xu5901/car_template/3-参考资料/编码器参数.jpg

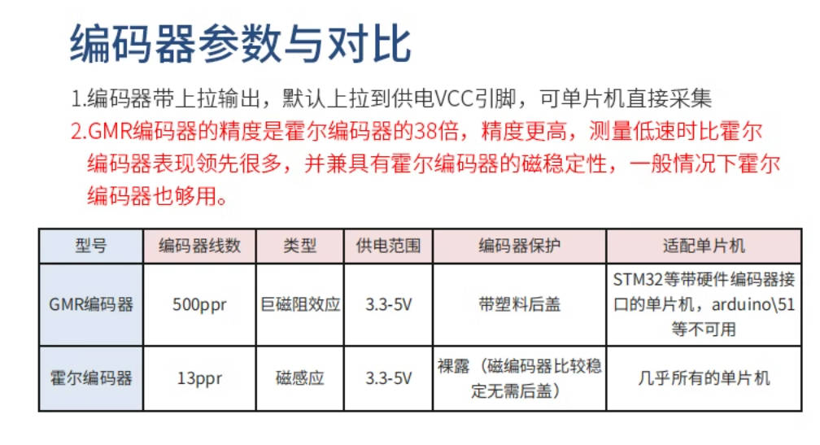
3-参考资料/编码器参数.jpg
