xu5901/car_template/4-小车PCB/小车基本板/3.说明文档/小车基本板A4950_PCB_3D预览.jpg

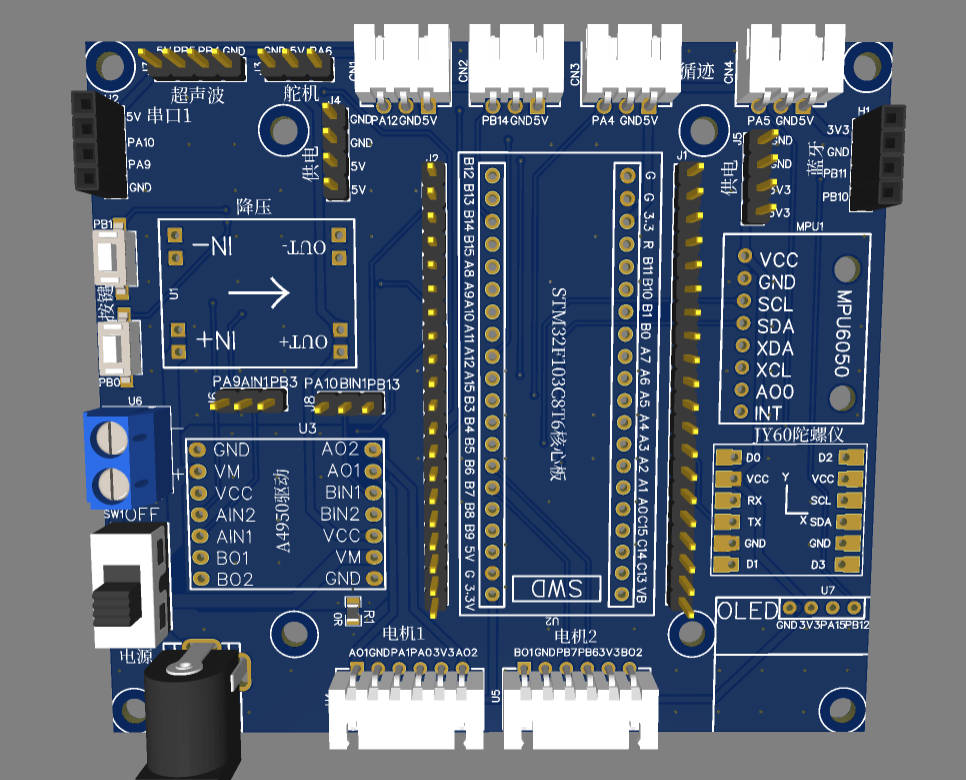
4-小车PCB/小车基本板/3.说明文档/小车基本板A4950_PCB_3D预览.jpg
