xu5901/car_template/1-工程源码/版本说明.txt

版本顺序为我的移植顺序，V7.0及之后的版本已经具备所有功能，V8.1为最终综合测试版本，根据需求选择相应版本。
cubemx可能不支持中文路径，可以放在英文路径下打开。自己添加的外设文件都在HARDWARE文件夹中。
