xu5901/car_template/3-参考资料/MG370_MG310电机参数.jpg

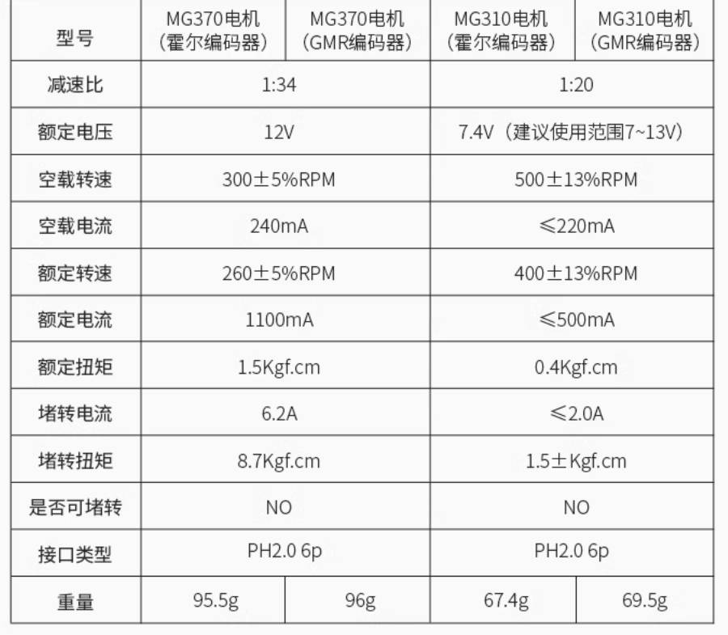
3-参考资料/MG370_MG310电机参数.jpg
