xu5901/car_template/3-参考资料/MG370轮胎65mm.jpg

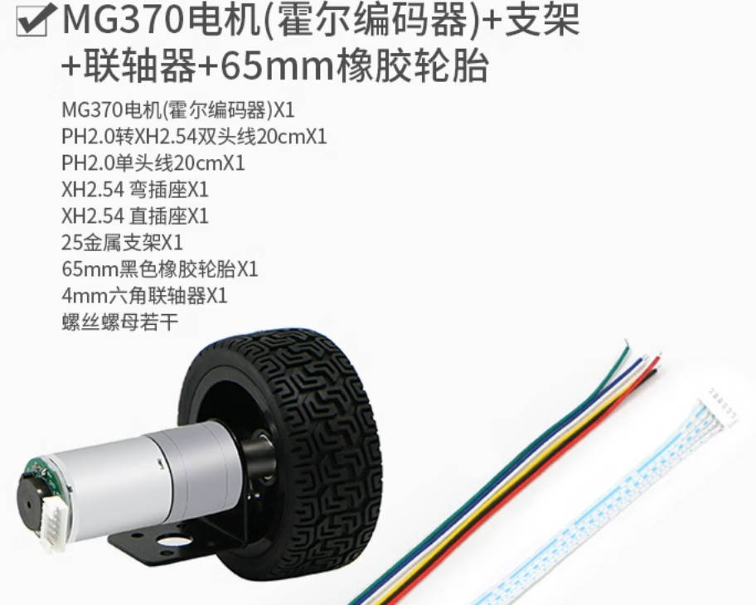
3-参考资料/MG370轮胎65mm.jpg
