xu5901/car_template/3-参考资料/位置速度串级PID流程框图.jpg

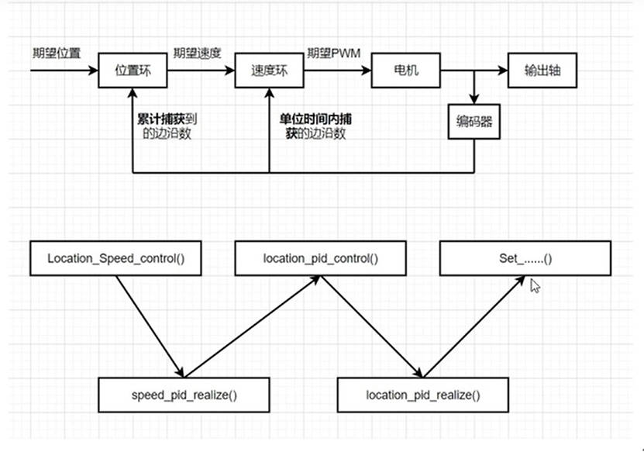
3-参考资料/位置速度串级PID流程框图.jpg
