xu5901/car_template/3-参考资料/参考小车教程.jpg

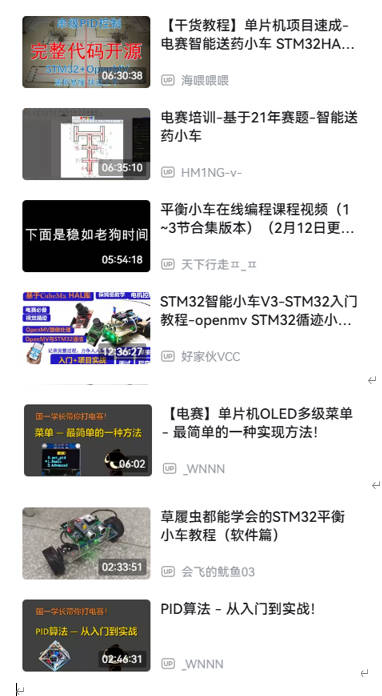
3-参考资料/参考小车教程.jpg
