xu5901/car_template/3-参考资料/我的硬件清单.txt

电机：370电机
编码器：13线霍尔编码器
电机驱动：TB6612
陀螺仪：JY901S，上位机配置为六轴
主控：STM32F103C8T6
OLED：四针脚
蓝牙：HC05
12V电池
5V稳压模块
