xu5901/car_template/2-调试说明/速度位置串级pid调试步骤.pdf

速度位置串级pid调试步骤
一、上位机准备
二、调速度环
1、调p
2、调i
3、设置闭环死区与积分限幅
三、调位置环
四、总结
五、补充1，蓝牙无线调试
六、补充2，角度环调试
七、补充3，巡线环调试

# 速度位置串级pid调试步骤

# 一、上位机准备

将对应代码取消注释，具体看视频。

# 二、调速度环

1、调p

看极性，输入一个较大的数(数量级)，看是否向目标值靠近，靠近则极性正确。

根据输入(期望速度值，一般为系统允许最大值的60%-70%)和输出(pwm)估算数量级。

调节p值刚好出现过冲现象，在这个值左右改动会有明显差别，将这个数值乘0.6即为实际应用的值。效 果为慢慢到达目标值。

刚好过冲：

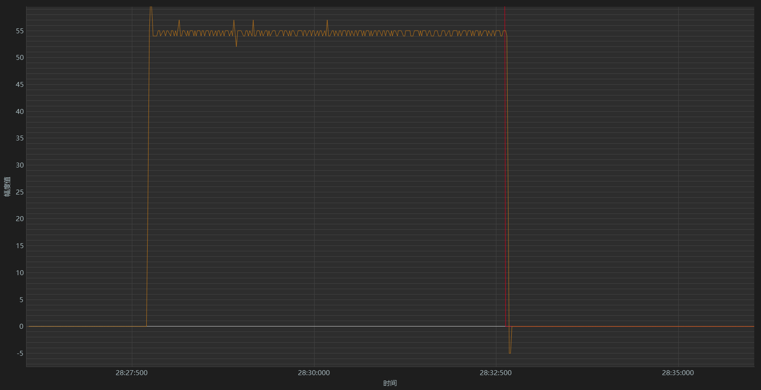
[picture p41: figure]

2、调i

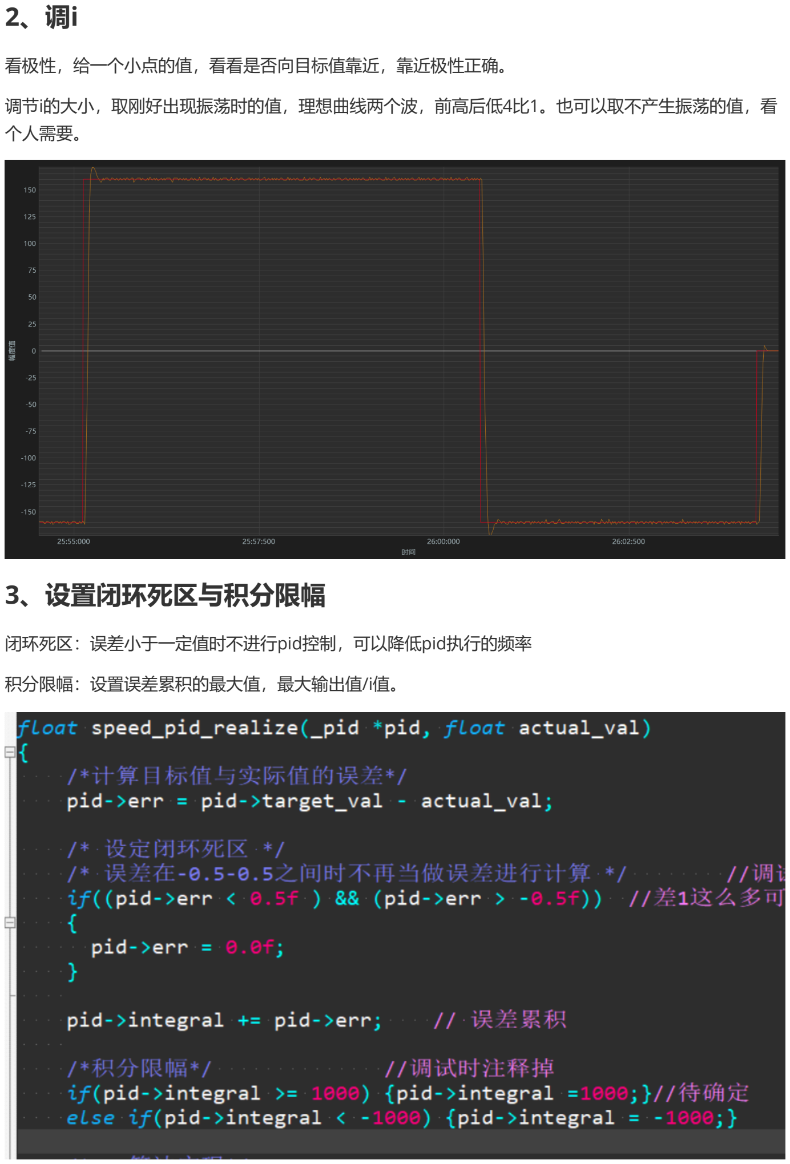
[picture p42: page 2]

看极性，给一个小点的值，看看是否向目标值靠近，靠近极性正确。

调节i的大小，取刚好出现振荡时的值，理想曲线两个波，前高后低4比1。也可以取不产生振荡的值，看 个人需要。

## 3、设置闭环死区与积分限幅

闭环死区：误差小于一定值时不进行pid控制，可以降低pid执行的频率

积分限幅：设置误差累积的最大值，最大输出值/i值。

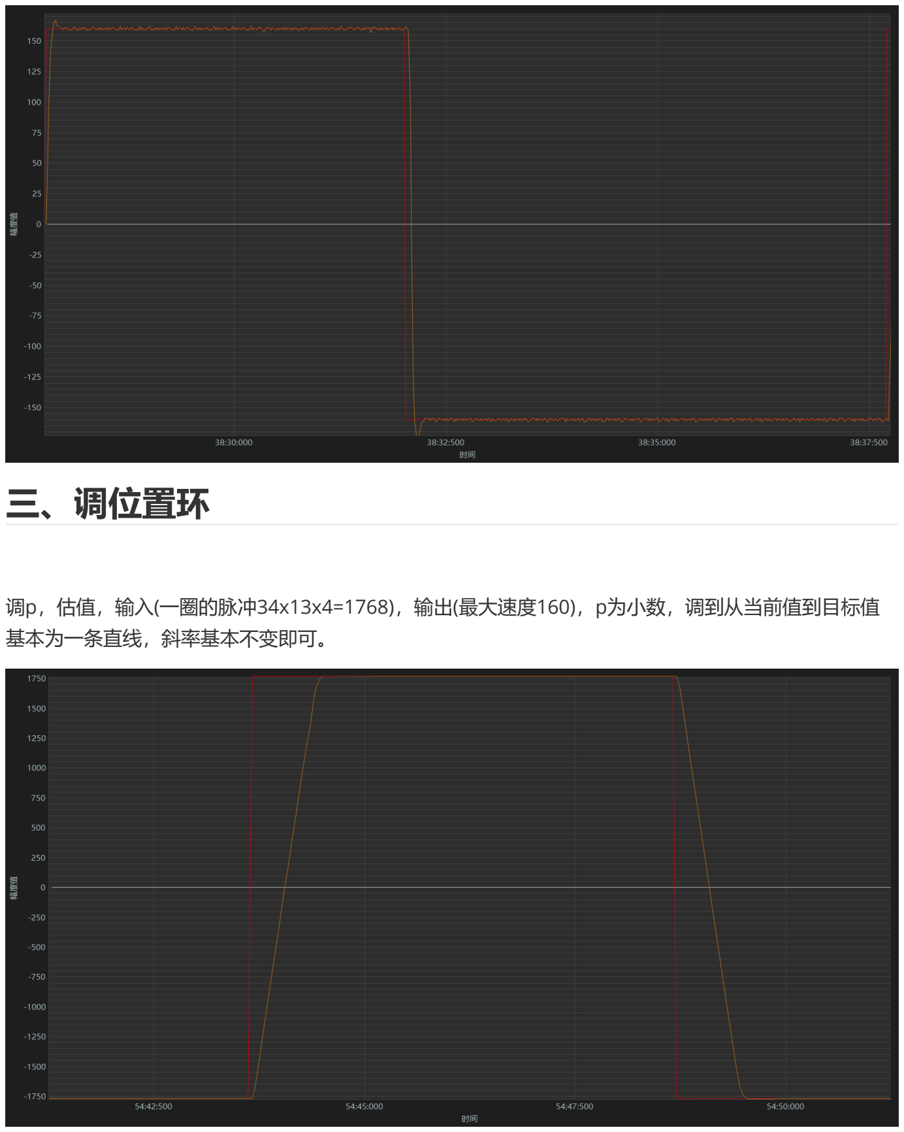
[picture p43: page 3]

# 三、调位置环

调p，估值，输入(一圈的脉冲34x13x4=1768)，输出(最大速度160)，p为小数，调到从当前值到目标值 基本为一条直线，斜率基本不变即可。

# 四、总结

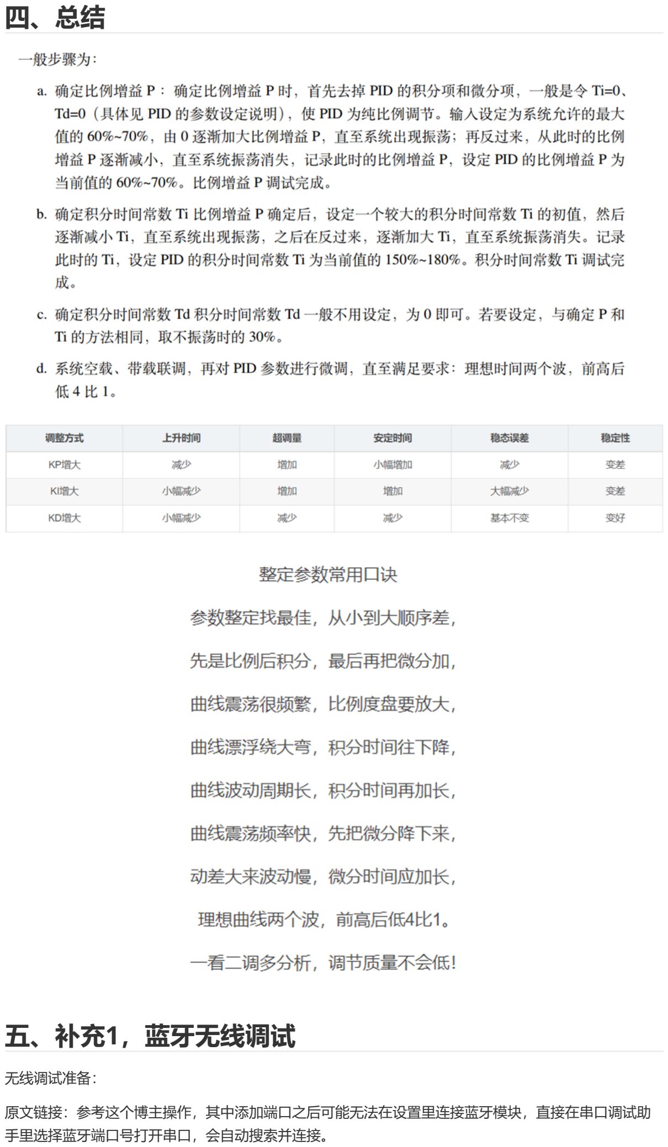
[picture p44: page 4]

# 五、补充1，蓝牙无线调试

无线调试准备：

原文链接：参考这个博主操作，其中添加端口之后可能无法在设置里连接蓝牙模块，直接在串口调试助 手里选择蓝牙端口号打开串口，会自动搜索并连接。

电脑连接蓝牙模块HC05

https://blog.csdn.net/TENET123/article/details/139554032

# 六、补充2，角度环调试

调试角度环，p值不宜给过大，否则可能使车子在陀螺仪边界值附近发生跃变，转个不停。

可以通过设置闭环死区的方式避免这种情况的发生。

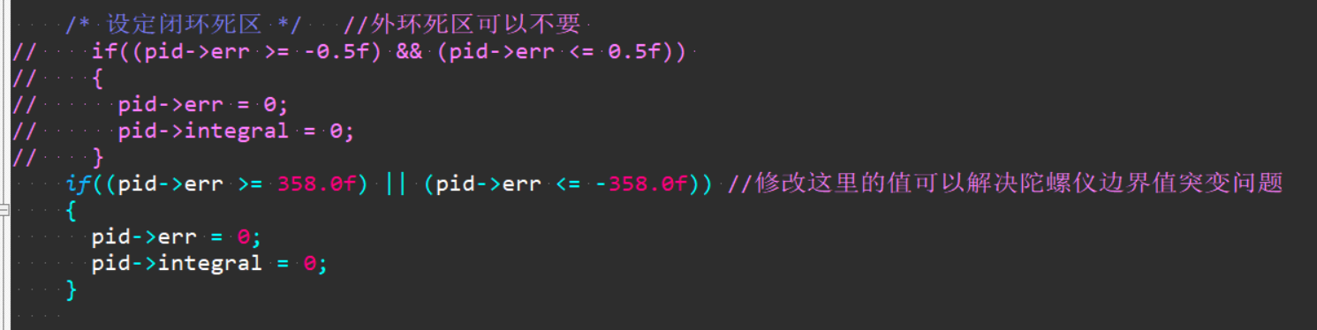
[picture p45: figure]

# 七、补充3，巡线环调试

简单巡线时，可以不用巡线环，直接用速度环，将灰度巡线值加减在速度环期望值上，实现差速转弯， 减小计算量。
