xu5901/car_template/2-调试说明/位置环p值效果.png

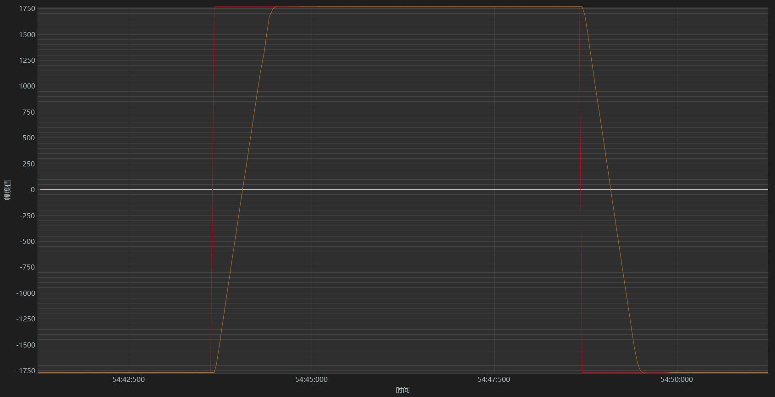
2-调试说明/位置环p值效果.png
