xu5901/car_template/2-调试说明/速度环i值效果.png

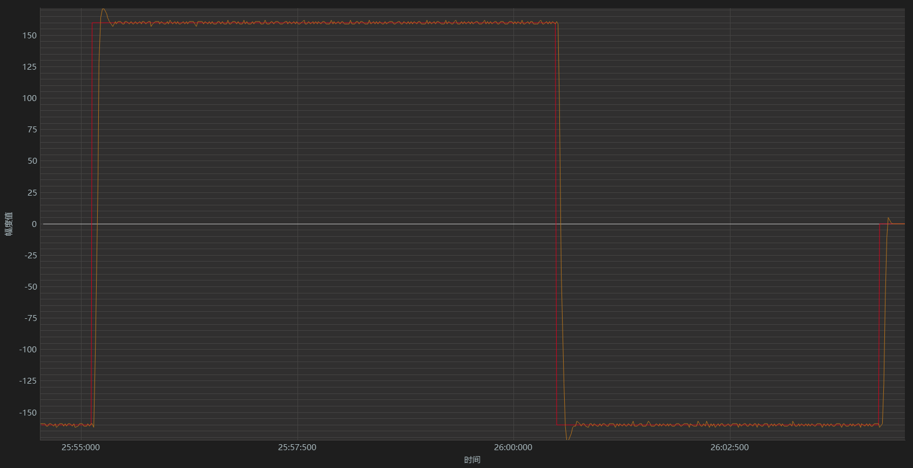
2-调试说明/速度环i值效果.png
