xu5901/car_template/4-小车PCB/小车基本板/2.原理图/Schematic_小车基本板TB6612.pdf

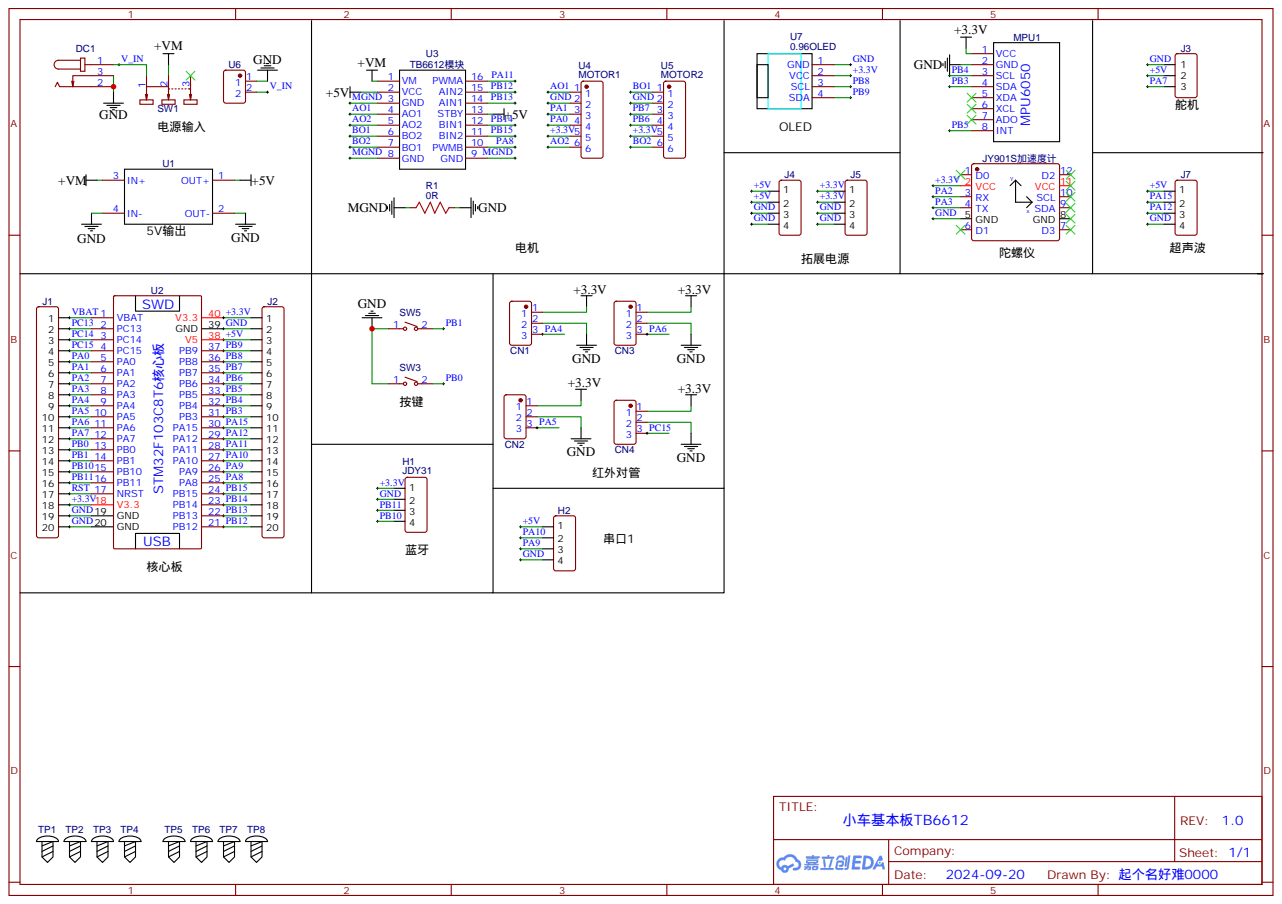
[picture p49: page 1]
