xu5901/car_template/1-工程源码/MyCar_V8.1/f103c8t6_test/Core/Inc/main.h

#define LED0_Pin GPIO_PIN_13
#define LED0_GPIO_Port GPIOC
#define HW4_Pin GPIO_PIN_15
#define HW4_GPIO_Port GPIOC
#define HW1_Pin GPIO_PIN_4
#define HW1_GPIO_Port GPIOA
#define HW2_Pin GPIO_PIN_5
#define HW2_GPIO_Port GPIOA
#define HW3_Pin GPIO_PIN_6
#define HW3_GPIO_Port GPIOA
#define KEY0_Pin GPIO_PIN_0
#define KEY0_GPIO_Port GPIOB
#define KEY1_Pin GPIO_PIN_1
#define KEY1_GPIO_Port GPIOB
#define AIN2_Pin GPIO_PIN_12
#define AIN2_GPIO_Port GPIOB
#define AIN1_Pin GPIO_PIN_13
#define AIN1_GPIO_Port GPIOB
#define BIN1_Pin GPIO_PIN_14
#define BIN1_GPIO_Port GPIOB
#define BIN2_Pin GPIO_PIN_15
#define BIN2_GPIO_Port GPIOB
#define SDA_6050_Pin GPIO_PIN_3
#define SDA_6050_GPIO_Port GPIOB
#define SCL_6050_Pin GPIO_PIN_4
#define SCL_6050_GPIO_Port GPIOB
#define OLED_SCL_Pin GPIO_PIN_8
#define OLED_SCL_GPIO_Port GPIOB
#define OLED_SDA_Pin GPIO_PIN_9
#define OLED_SDA_GPIO_Port GPIOB
