xu5901/car_template/(notices)

Notices in the files:
1-工程源码/MyCar_V8.1/f103c8t6_test/Core/Inc/main.h:
Copyright (c) 2024 STMicroelectronics.
All rights reserved.
This software is licensed under terms that can be found in the LICENSE file
